yichengsun/blumen-lumen/frontend/src/Imgs/blumen-viz-v3.jpg

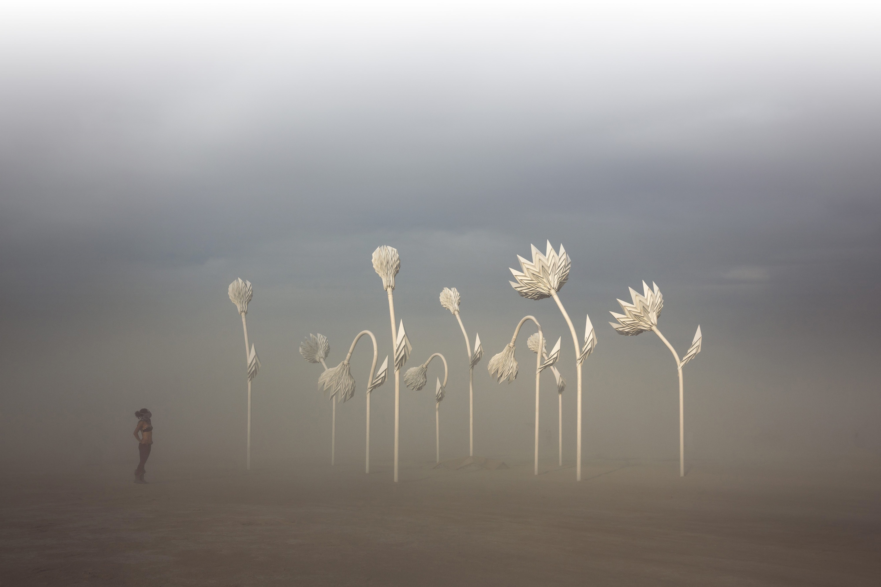
frontend/src/Imgs/blumen-viz-v3.jpg
