yichengsun/blumen-lumen/frontend/src/Imgs/blumen-viz-v1.jpg

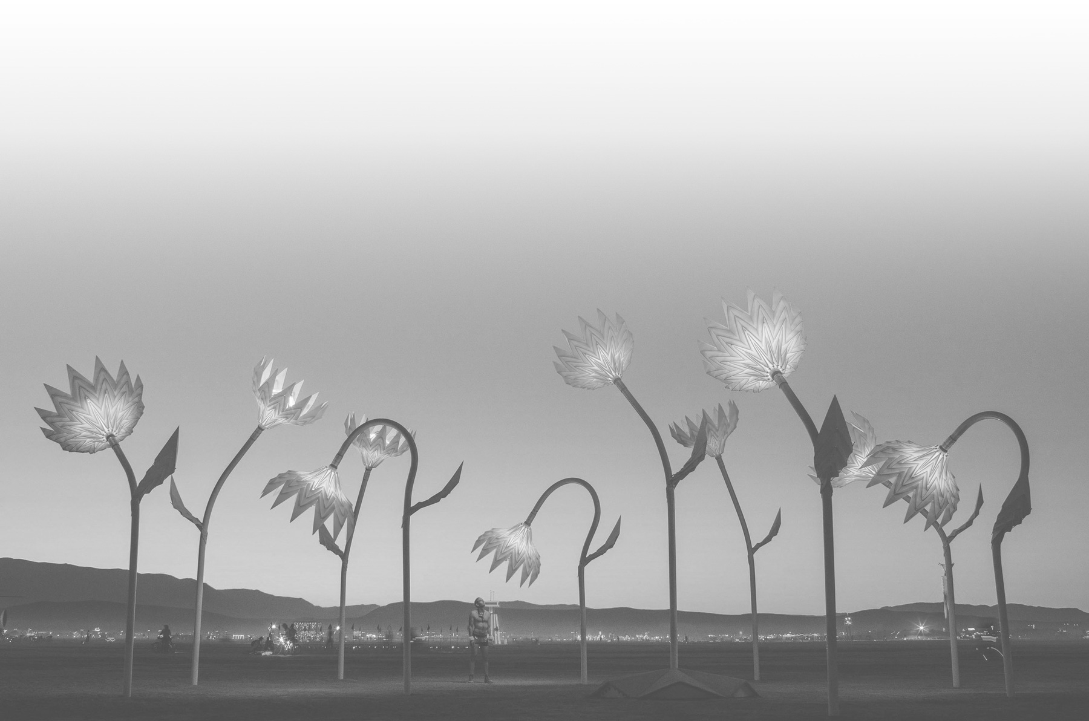
frontend/src/Imgs/blumen-viz-v1.jpg
