yichengsun/blumen-lumen/frontend/src/Imgs/blumen-viz-v2.jpg

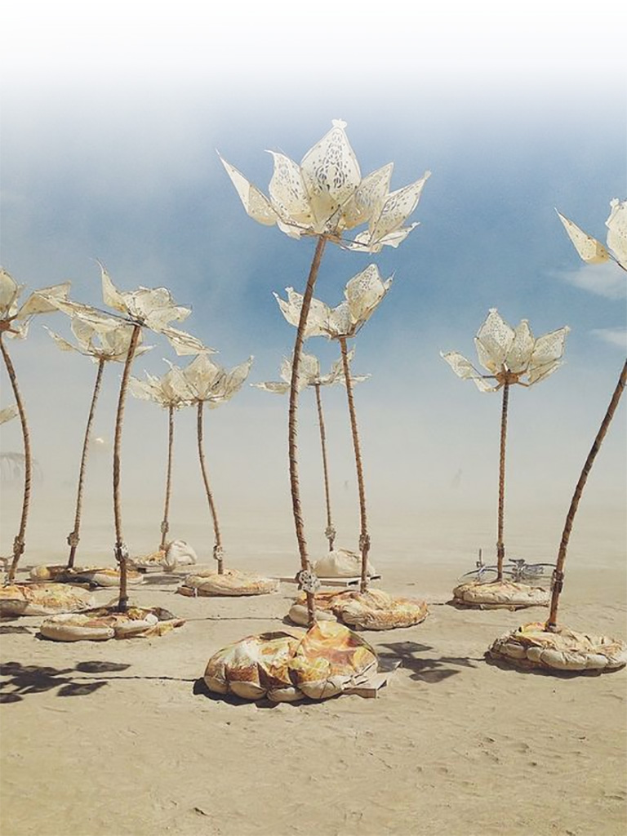
frontend/src/Imgs/blumen-viz-v2.jpg
