yichengsun/blumen-lumen/frontend/src/Imgs/NavButton0.png

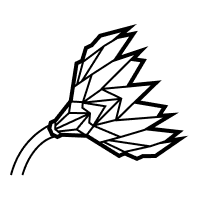
frontend/src/Imgs/NavButton0.png
