yichengsun/blumen-lumen/frontend/src/Imgs/NavButton1.png

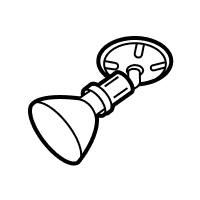
frontend/src/Imgs/NavButton1.png
