yichengsun/blumen-lumen/Arduino/blumen-motor/MotorController.cpp

#include "MotorController.h"
#include <Arduino.h>
// analogWrite.h removed — analogWrite() is built into ESP32 core 3.x

/*
   Stop:
    Analog - 0
   Extend:
    Analog - 255
    Digital - LOW
   Retract:
    Analog - 255
    Digital - HIGH
*/

MotorController::MotorController(int directionPin, int pwmPin, bool debugMode = false) {
  pinMode(directionPin, OUTPUT);
//  pinMode(pwmPin, OUTPUT);
//  pinMode(LED_BUILTIN, OUTPUT);

  _directionPin = directionPin;
  _pwmPin = pwmPin;
  _debugMode = debugMode;
}

void MotorController::freeze() {
  analogWrite(_pwmPin, 0);

  if(_debugMode) {
    Serial.println("Freeze");
//    digitalWrite(LED_BUILTIN, LOW);
  }
}

void MotorController::extend() {
  digitalWrite(_directionPin, LOW);
  analogWrite(_pwmPin, 255);
  
  if(_debugMode) {
    Serial.println("Extend");
//    digitalWrite(LED_BUILTIN, HIGH);
  }
}

void MotorController::retract() {
  digitalWrite(_directionPin, HIGH);
  analogWrite(_pwmPin, 255);
  
  if(_debugMode) {
    Serial.println("Retract");
//    digitalWrite(LED_BUILTIN, HIGH);
  }
}
