yichengsun/blumen-lumen/(commit log)

2026-06-11 Add Blumen Lumen technical documentation
    Comprehensive student-facing reference covering system architecture,
    hardware components (ESP32, Cytron MD30C R2, Advatek PixLite 16,
    Mean Well PSUs), wiring, network topology, software stack, OSC API,
    startup sequence, hacking guide, and troubleshooting.
2026-06-11 Visual confirmation of the LED strip model, no explicit model number seen
2026-06-12 Add MAC address placeholders, Arduino IDE setup guide, baud rate notes
2026-06-12 Add TODO for updating backend ESP32 IP once IT provides DHCP reservation
2026-06-12 Update docs: startup behavior, ambient schedule, boot calibration
    - Section 8: reflect new startup.bat (named windows, admin note, MadMapper
    auto-launches via Windows startup items); note flower retracts to closed
    on ESP32 boot; add manual startup fallback commands
    - Section 6.4: remove outdated static IP / moveAtTime() references; update
    to reflect DHCP + open Stanford WiFi; add sections 6.4.1 (boot behavior)
    and 6.4.2 (autonomous schedule) with full timetable and explanation of
    manual-vs-schedule interaction
    - Section 6.1: note window.location.hostname means no IP editing needed
    - Section 6.2: note oscClient now uses 127.0.0.1 (localhost) for MadMapper
    - TODOs: mark window.locati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
2026-06-12 Add all source code — Arduino, backend, frontend, MadMapper, startup
    Consolidates the full Blumen Lumen codebase into this independent repo
    so students have a single source of truth not tied to IDEO or FoldHaus orgs.
    Source: FoldHaus/blumen-lumen-ideo stanford-test branch (Arduino, backend,
    frontend copy, startup) + ideo/ddl-ipad stanford-test branch (frontend).
    All Stanford-specific fixes are included:
    - Arduino: Stanford WiFi, DHCP, retract-to-closed boot calibration,
    NTP schedule, improved logging and serial commands
    - backend: MadMapper OSC → 127.0.0.1, port error handling, blumenOpenLevel=0
    - frontend: window.location.hostname (no hardcoded IP)
    - startup.bat: named wind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
    [MotorController.cpp, blumen-motor.ino]
2026-06-12 Add WiFi timeout so serial commands work without network
    Previously the WiFi connect loop in setup() blocked forever if the
    network was unavailable, making serial commands unreachable. Now:
    - 20-second timeout (40 × 500ms attempts) before continuing
    - If WiFi fails: prints WARNING + MAC address (useful for IT registration)
    then proceeds to calibration — serial commands and schedule still work
    - OSC receive in loop() gated on WiFi.status() == WL_CONNECTED
    - WiFi watchdog log message clarified ("not connected" vs "dropped")
    [blumen-motor.ino]
2026-06-12 Print MAC address on every boot before WiFi connect
    Useful for IT network registration without needing a separate sketch.
2026-06-12 Remove ESP32_AnalogWrite dependency — use built-in analogWrite (core 3.x)
    ESP32 core 3.x removed ledcSetup/ledcAttachPin and folded analogWrite()
    into the core. Drop the external library include; no code change needed.
2026-06-12 Fix 4 Arduino bugs; update docs with ESP32 MAC and IP
    Arduino fixes:
    - Remove duplicate MAC print on successful WiFi connect
    - Skip NTP when WiFi is not connected (needs internet)
    - Fix UDP not restarting after WiFi drop/reconnect (udpReady flag +
    watchdog now calls Udp.begin() + NTP re-sync on reconnection)
    - Guard motorMover() against delta=0 to prevent spurious motor pulse
    Docs:
    - ESP32 MAC: 24:0A:C4:EC:A7:64
    - ESP32 current DHCP IP: 10.34.84.37 (not yet reserved — pending IT)
    [blumen-motor.ino]
2026-06-13 Add session handoff doc for NUC continuation
    Current state: motor working, LEDs in progress. Next step is
    configuring MadMapper Art-Net output to PixLite at 192.168.0.50.
2026-06-13 Update networking, fix mobile layout, add datasheets
    - Set ESP32 IP to 10.34.84.37 in backend/app.js (current DHCP; update when IT reserves)
    - Fix Startup/blumen-startup.bat paths to match NUC clone location
    - Add mobile-portrait responsive CSS (max-width: 480px) to fix iPad-only layout:
    nav margins, content height, toggle width, timer message position, color swatches
    - Add Datasheets/ folder with PDFs for all hardware components
2026-06-13 Serve frontend from backend on port 80, update docs with confirmed hardware info
    - backend: add Express 4 to serve built React app statically on port 80
    (eliminates separate frontend dev server and :3000 in URL)
    - Startup/blumen-startup.bat: start backend only (no more frontend server)
    - DOCUMENTATION.md: mark all confirmed TODOs done (WS2812B 12×70px,
    universe mapping, motor direction, FULL_PERIOD 70500ms confirmed,
    MadMapper OSC ports 8000/9000, PixLite IP/MAC, NUC IPs, port 80 serving);
    update low-confidence table; fix repo references to yichengsun/blumen-lumen
    - HANDOFF.md: rewrite to reflect full system working; replace in-progress
    notes with current IP table and remaining IT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
2026-06-13 Consolidate docs into README, remove HANDOFF and DOCUMENTATION
    README is now the single source of truth. Merged all confirmed
    hardware/network facts from DOCUMENTATION.md, fixed stale port-3000
    references, corrected paths (frontend/src/ not ddl-ipad/), and added
    student-facing callouts for the blocking motor, slider lockout timer,
    per-connection state, and ESP32 serial commands. CLAUDE.md updated to
    match current system state.
2026-06-13 Document Windows autostart items and scheduled power on/off
2026-06-13 Fix docs/code accuracy: document build step, clean up stale references
    - frontend/build/ is gitignored (generated); docs previously claimed it was
    pre-built and committed. Updated README, CLAUDE.md, and startup.bat to
    require 'npm install && npm run build' on first run after a fresh clone.
    backend/app.js now exits with a clear error if build/ is missing.
    - Delete extra MadMapper files (js-, pk-dreamlab-blumen.mad, pallete.txt)
    that were never referenced in docs (~26 MB).
    - Fix stale Arduino comment: ddl-ipad-backend/app.js → backend/app.js.
    - Align schedule comment: "evening" → "afternoon" to match README.
    [blumen-motor.ino]
